prime6809/PS2Keyboard_to_Matrix/(threads)

Thread 1 (2023-10-15):

Serial debugging not working

JoopIdema, 2023-10-15:
I've have build the board using a ATMEGA164P-20PU on 20Mhz and connecting it to a C64. That works great.
I programmed it using a TL866II-plus in parallel mode. It took me a while to figure out the Fuse Byte settings, but as said, it is working now, but a cannot get serial debugging to work.
I added jumper  to JPS3 and I get output, but it is not readable. I tried different baudrates starting with 115200, 8N1. But none of them seem to work.
Any idea what I'm doing wrong? In the picture you can see the Fuse byte settings I'm using.

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
