prime6809/PS2Keyboard_to_Matrix/Hardware/generic/PS2Kbd.pdf

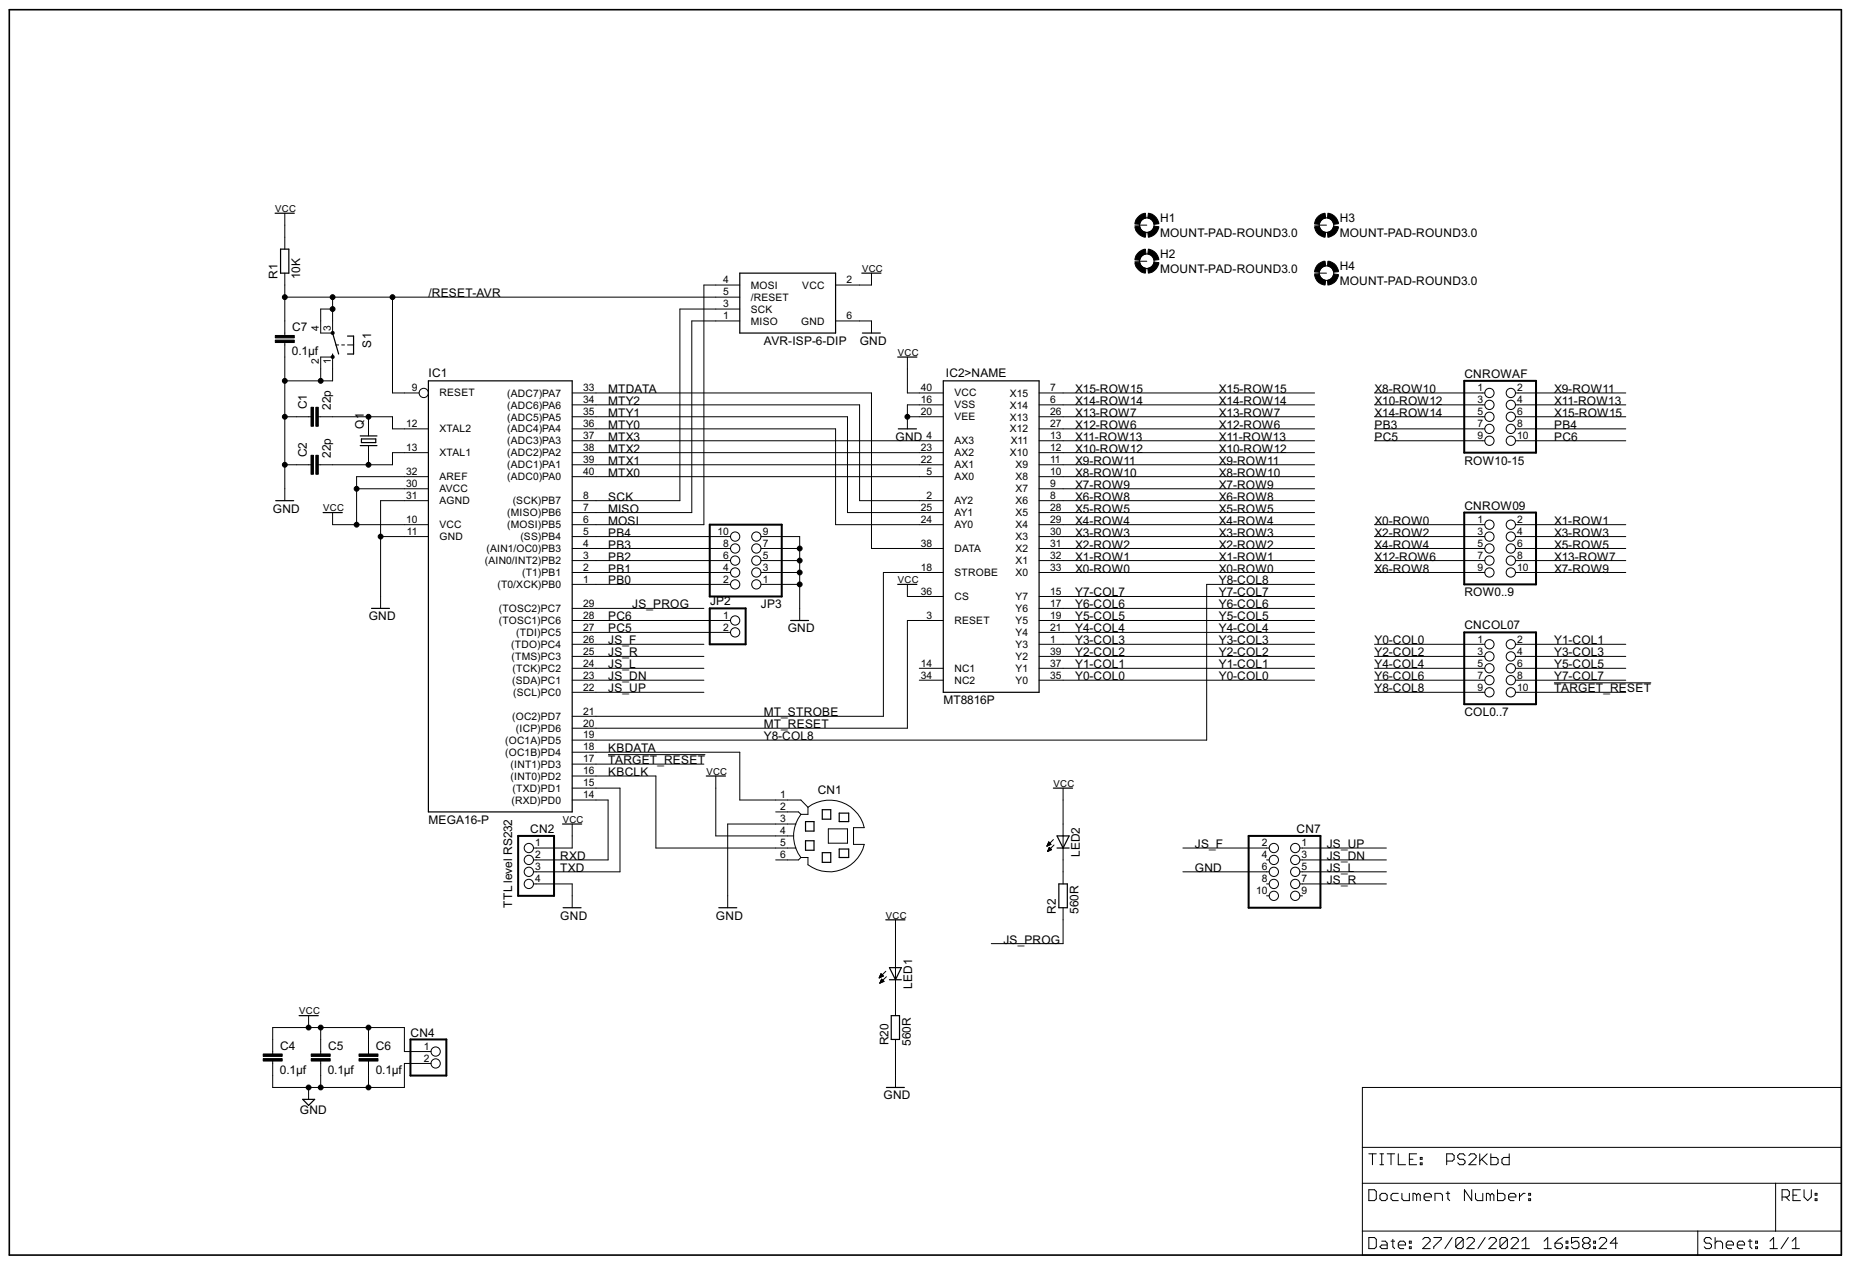
[picture p1: page 1]

40 | 10 X9 X8-ROW10 X8-ROW10
