prime6809/PS2Keyboard_to_Matrix/Hardware/generic/PS2Kbd.brd

## EAGLE design Hardware/generic/PS2Kbd.brd (2021-02-27)

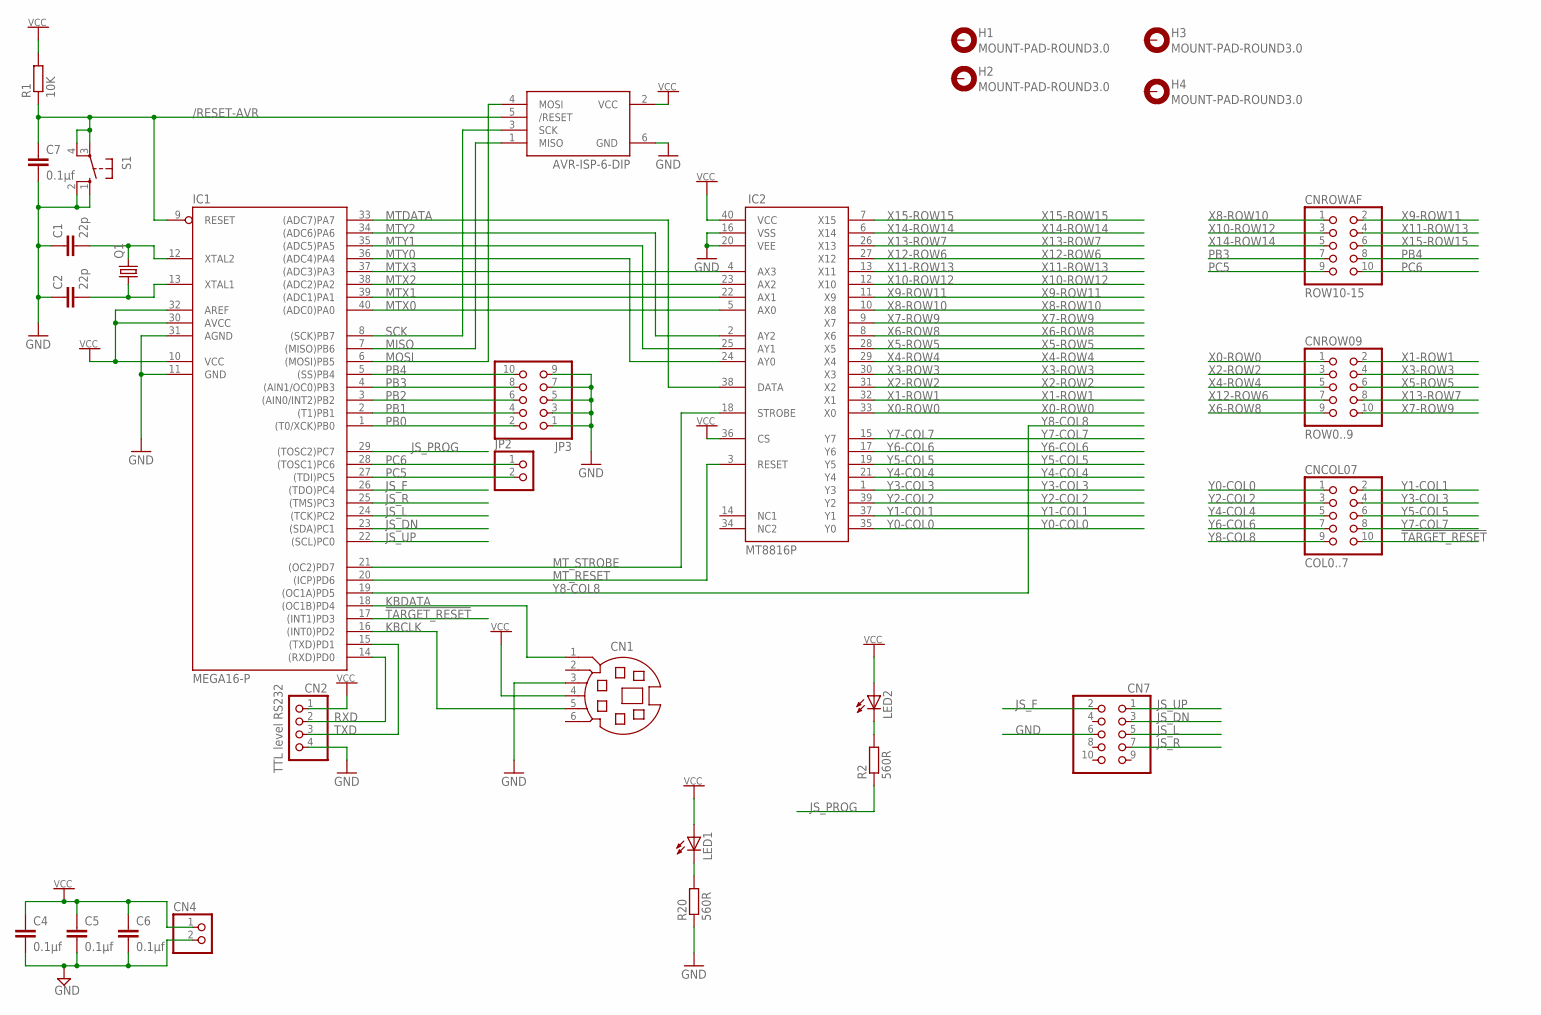
[picture p2: schematic PS2Kbd.sch]

Parts:
C1, C2: 22p; C025-025X050
C4, C5, C6, C7: 0.1µf; C025-025X050
CN1: MD06SS; MDIN06SS
CN2: PINHD-1X4; 1X04
CN3: AVR-ISP-6-DIP; 2X3
CN4: PINHD-1X2; 1X02
CN7: PINHD-2X5; 2X05
CNCOL07: COL0..7; 2X05
CNROW09: ROW0..9; 2X05
CNROWAF: ROW10-15; 2X05
H1, H2, H3, H4: MOUNT-PAD-ROUND3.0; 3,0-PAD
IC1: MEGA16-P; DIL40
IC2: MT8816P; DIL40
JP2: PINHD-1X2; 1X02
JP3: PINHD-2X5; 2X05
LED1, LED2: LED3MM
Q1: CRYSTALHC49S; HC49/S
R1: 10K; 0207/10
R2, R20: 560R; 0207/10
S1: 10-XX; B3F-10XX

Connections:
!TARGET_RESET: CNCOL07.10, IC1.17 ((INT1)PD3)
/RESET-AVR: C7.1, CN3.5 (/RESET), IC1.9 (RESET), R1.1, S1.3, S1.4 (P1)
GND: C1.1, C2.1, C4.2, C5.2, C6.2, C7.2, CN1.3, CN2.4, CN3.6 (GND), CN4.2, CN7.6, IC1.11 (GND), IC1.31 (AGND), IC2.16 (VSS), IC2.20 (VEE), JP3.1, JP3.3, JP3.5, JP3.7, JP3.9, R20.1, S1.1 (S), S1.2 (S1)
JS_DN: CN7.3, IC1.23 ((SDA)PC1)
JS_F: CN7.2, IC1.26 ((TDO)PC4)
JS_L: CN7.5, IC1.24 ((TCK)PC2)
JS_PROG: IC1.29 ((TOSC2)PC7), R2.1
JS_R: CN7.7, IC1.25 ((TMS)PC3)
JS_UP: CN7.1, IC1.22 ((SCL)PC0)
KBCLK: CN1.5, IC1.16 ((INT0)PD2)
KBDATA: CN1.1, IC1.18 ((OC1B)PD4)
MISO: CN3.1 (MISO), IC1.7 ((MISO)PB6)
MOSI: CN3.4 (MOSI), IC1.6 ((MOSI)PB5)
MTDATA: IC1.33 ((ADC7)PA7), IC2.38 (DATA)
MTX0: IC1.40 ((ADC0)PA0), IC2.5 (AX0)
MTX1: IC1.39 ((ADC1)PA1), IC2.22 (AX1)
MTX2: IC1.38 ((ADC2)PA2), IC2.23 (AX2)
MTX3: IC1.37 ((ADC3)PA3), IC2.4 (AX3)
MTY0: IC1.36 ((ADC4)PA4), IC2.24 (AY0)
MTY1: IC1.35 ((ADC5)PA5), IC2.25 (AY1)
MTY2: IC1.34 ((ADC6)PA6), IC2.2 (AY2)
MT_RESET: IC1.20 ((ICP)PD6), IC2.3 (RESET)
MT_STROBE: IC1.21 ((OC2)PD7), IC2.18 (STROBE)
unnamed: LED2.K (C), R2.2
unnamed: C1.2, IC1.12 (XTAL2), Q1.2
unnamed: C2.2, IC1.13 (XTAL1), Q1.1
unnamed: LED1.K (C), R20.2
PB0: IC1.1 ((T0/XCK)PB0), JP3.2
PB1: IC1.2 ((T1)PB1), JP3.4
PB2: IC1.3 ((AIN0/INT2)PB2), JP3.6
PB3: CNROWAF.7, IC1.4 ((AIN1/OC0)PB3), JP3.8
PB4: CNROWAF.8, IC1.5 ((SS)PB4), JP3.10
PC5: CNROWAF.9, IC1.27 ((TDI)PC5), JP2.2
PC6: CNROWAF.10, IC1.28 ((TOSC1)PC6), JP2.1
RXD: CN2.2, IC1.14 ((RXD)PD0)
SCK: CN3.3 (SCK), IC1.8 ((SCK)PB7)
TXD: CN2.3, IC1.15 ((TXD)PD1)
VCC: C4.1, C5.1, C6.1, CN1.4, CN2.1, CN3.2 (VCC), CN4.1, IC1.10 (VCC), IC1.30 (AVCC), IC1.32 (AREF), IC2.36 (CS), IC2.40 (VCC), LED1.A, LED2.A, R1.2
X0-ROW0: CNROW09.1, IC2.33 (X0)
X1-ROW1: CNROW09.2, IC2.32 (X1)
X2-ROW2: CNROW09.3, IC2.31 (X2)
X3-ROW3: CNROW09.4, IC2.30 (X3)
X4-ROW4: CNROW09.5, IC2.29 (X4)
X5-ROW5: CNROW09.6, IC2.28 (X5)
X6-ROW8: CNROW09.9, IC2.8 (X6)
X7-ROW9: CNROW09.10, IC2.9 (X7)
X8-ROW10: CNROWAF.1, IC2.10 (X8)
X9-ROW11: CNROWAF.2, IC2.11 (X9)
X10-ROW12: CNROWAF.3, IC2.12 (X10)
X11-ROW13: CNROWAF.4, IC2.13 (X11)
X12-ROW6: CNROW09.7, IC2.27 (X12)
X13-ROW7: CNROW09.8, IC2.26 (X13)
X14-ROW14: CNROWAF.5, IC2.6 (X14)
X15-ROW15: CNROWAF.6, IC2.7 (X15)
Y0-COL0: CNCOL07.1, IC2.35 (Y0)
Y1-COL1: CNCOL07.2, IC2.37 (Y1)
Y2-COL2: CNCOL07.3, IC2.39 (Y2)
Y3-COL3: CNCOL07.4, IC2.1 (Y3)
Y4-COL4: CNCOL07.5, IC2.21 (Y4)
Y5-COL5: CNCOL07.6, IC2.19 (Y5)
Y6-COL6: CNCOL07.7, IC2.17 (Y6)
Y7-COL7: CNCOL07.8, IC2.15 (Y7)
Y8-COL8: CNCOL07.9, IC1.19 ((OC1A)PD5)

Notes on the sheet:
TTL level RS232

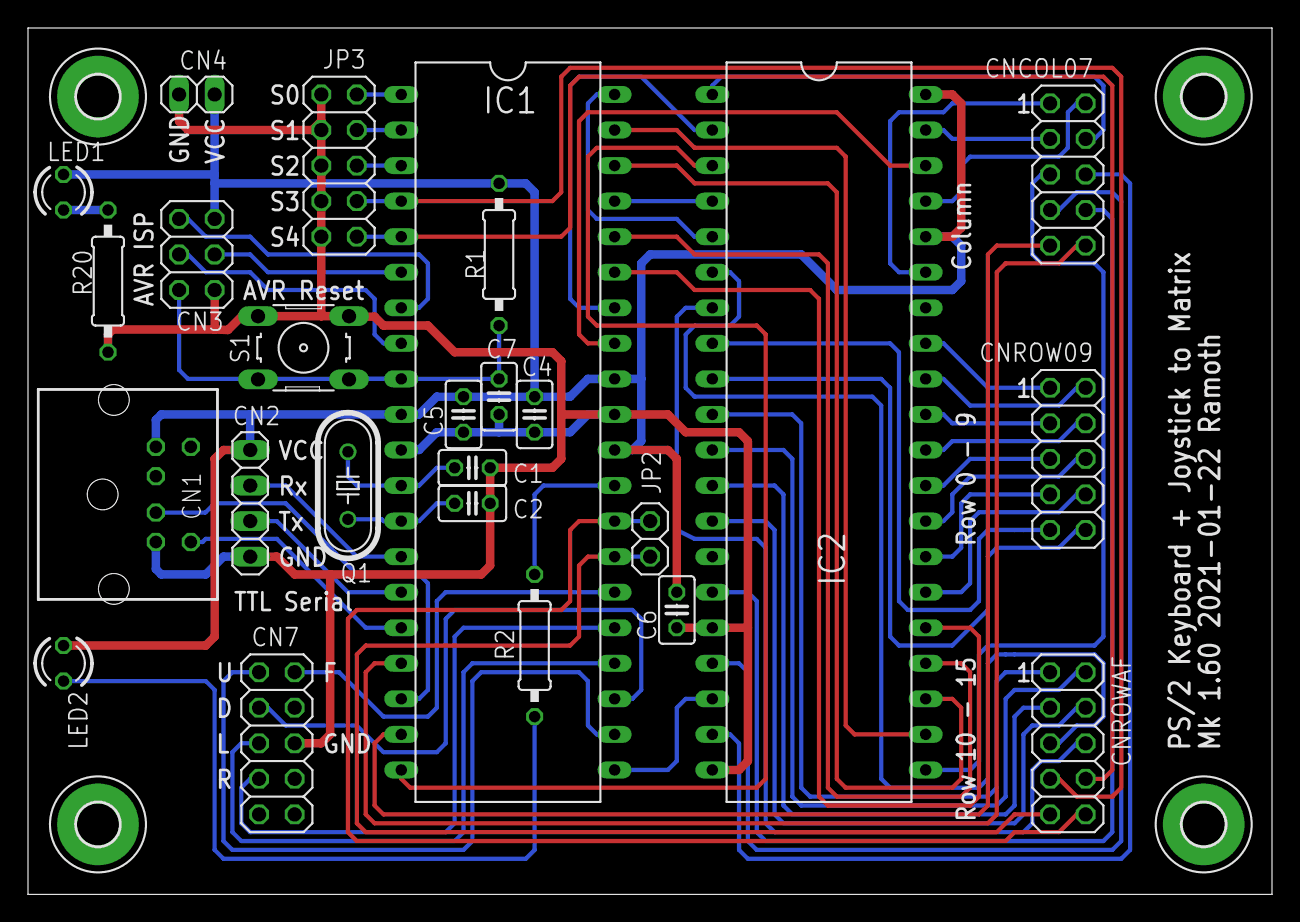
[picture p3: board PS2Kbd.brd from above]

Board: 2 copper layers, 88.9 x 61.9 mm, 29 parts (0 on the bottom side), 63 nets.
