prime6809/PS2Keyboard_to_Matrix/(commit log)

2021-01-11 Initial commit of source and hardware docs.
    [PS2Kbd.brd, PS2Kbd.sch]
2021-01-12 Updated building docs. Revised generic board.
    [PS2Kbd.brd, PS2Kbd.sch]
2021-01-14 Cleanup / removal of commented (no longer used) code
    [matrix_kbd.c, matrix_kbd.h]
2021-01-23 Moved target reset into common code. Implemented centralized initialization of jumpers, joystick and reset. Moved PS/2 LED handling into ps2kbd module. Added macros for setting / clearing LEDS.
    [PS2-to_matrix.c, globalio.c, globalio.h, io.c, io.h, ps2kbd.c, ps2kbd.h, scancode.c]
2021-01-23 Fixed Dragon / CoCo matrix so all keys are produced. Added matrix dumping code.
    [matrix_kbd.c, matrix_kbd.h, scancode.c]
2021-02-22 Various small changes, added ESC as break on TRS80.
2021-02-27 Alternate matrix for TRS80, allowing 1:1 cable.
2021-02-27 Added separate tables for TRS80 Model 3 / Model 4 as the 3 doesn't have some of the keys the 4 has (CTRL, CAPS and 3 function keys).
    Added pdf schematic and gerbers for Generic version of hardware.
    [PS2Kbd.brd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]
2024-10-22 Fixed the JSLEDOn macro.
    [globalio.h]
